somerhanna/Automatic-Chicken-Door/door_display.png

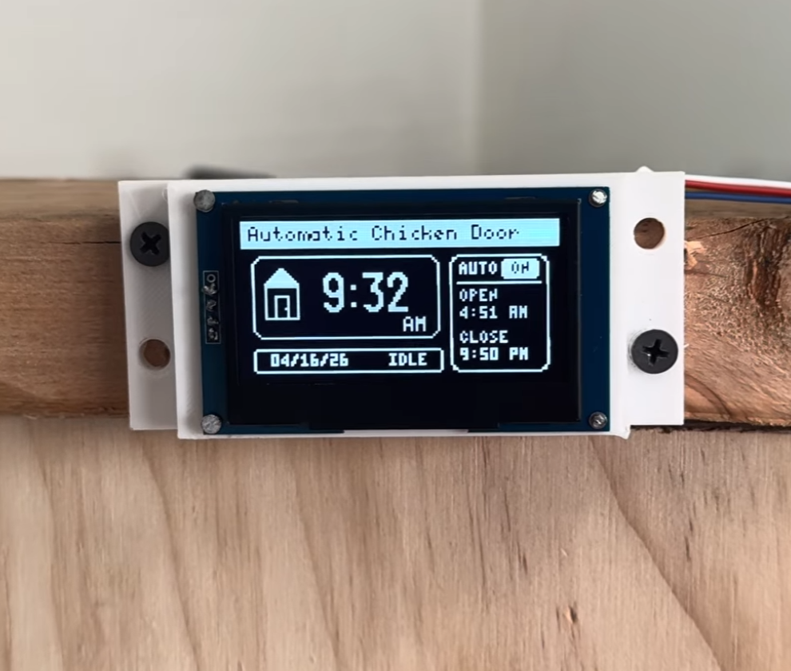
door_display.png
