somerhanna/Automatic-Chicken-Door/door_box.png

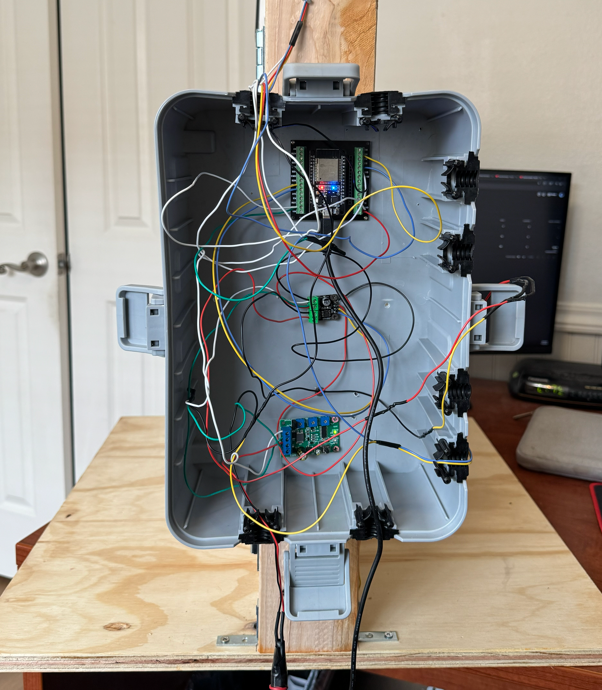
door_box.png
