somerhanna/Automatic-Chicken-Door/3D_utils/readme

The 3D models I made to house the limit switches and the 12V worm gear motor.

The 12V worm gear motor I used is commonly avaliable on various websites (Amazon, Temu, etc.) - BRINGSMART.

I added a picture of it so if you have the same one you can 3D print your own housing for it (it holds it very firmly).

Print the 2 halves and place them together, held with 2 screws. I also uploaded the full version.
