somerhanna/Automatic-Chicken-Door/3D_utils/wormgearmotor12.jpg

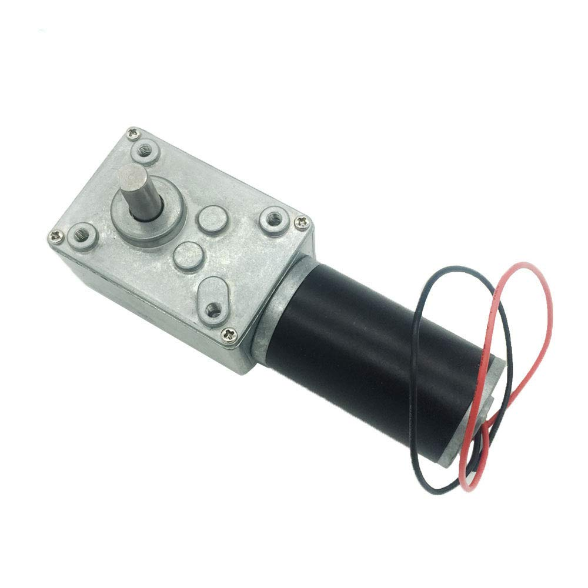
3D_utils/wormgearmotor12.jpg
