somerhanna/Automatic-Chicken-Door/chicken_door_app.png

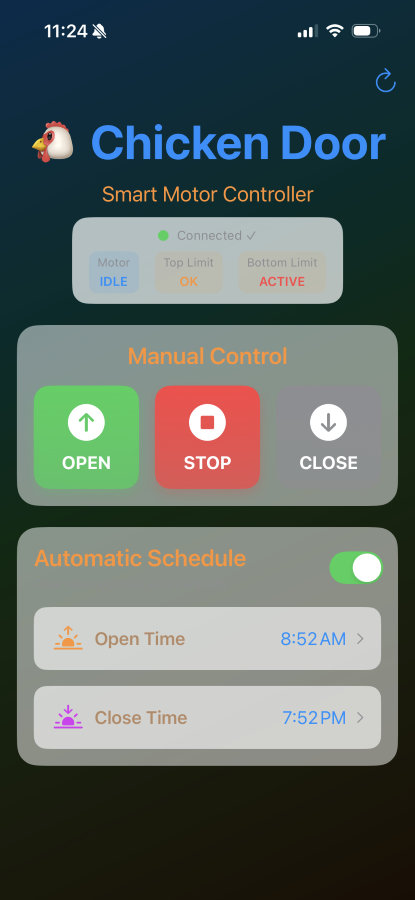
chicken_door_app.png
