somerhanna/Automatic-Chicken-Door/door_back.png

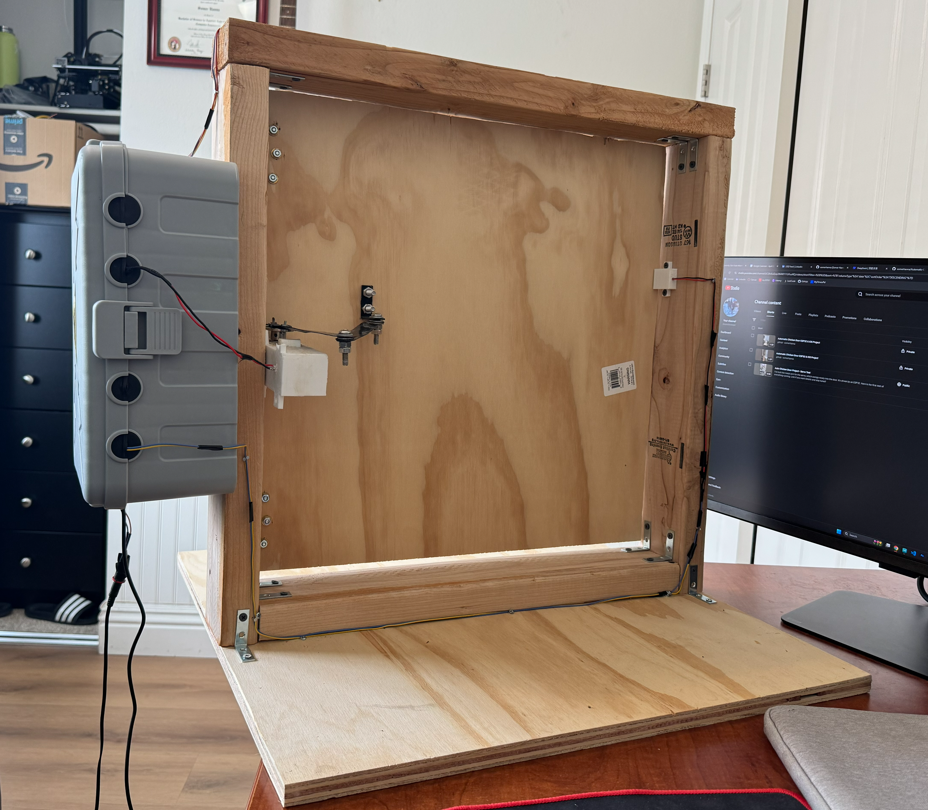
door_back.png
