somerhanna/Automatic-Chicken-Door/door_front.png

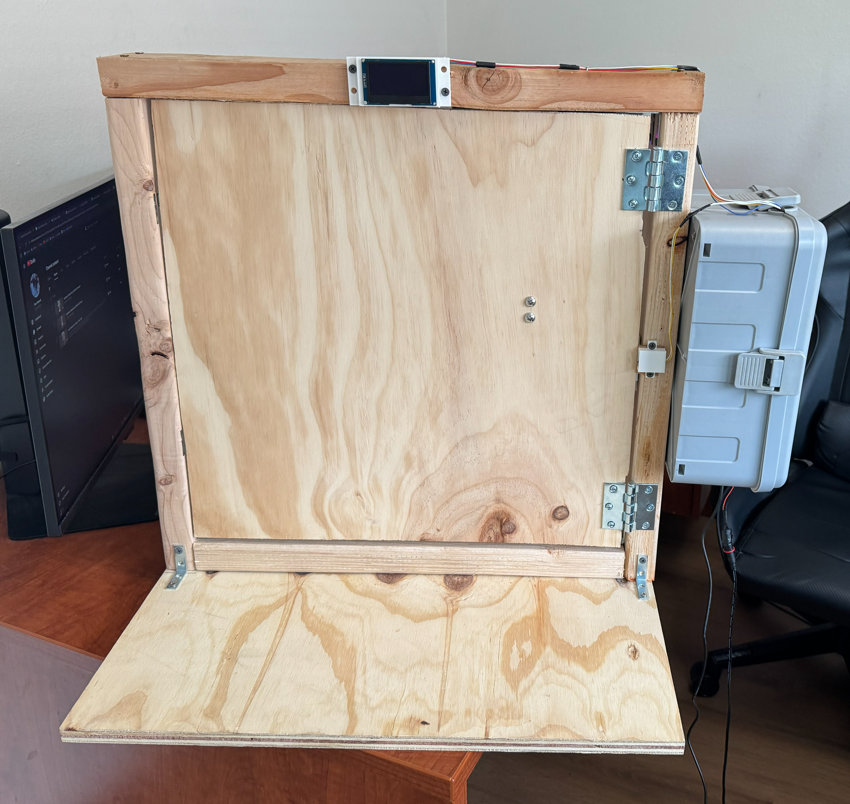
door_front.png
