somerhanna/Automatic-Chicken-Door/pin_config.png

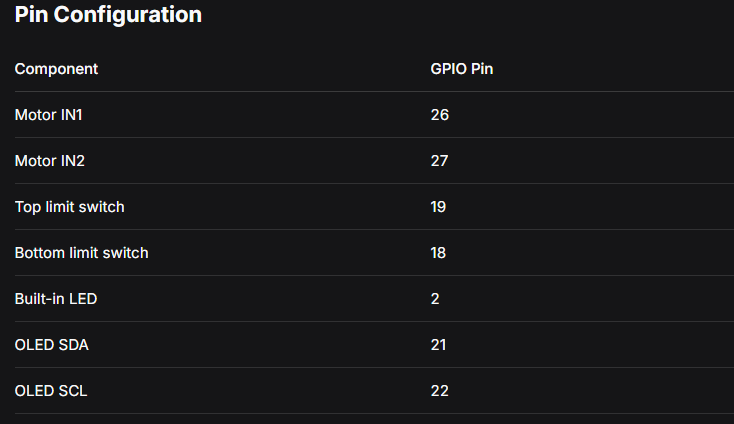
pin_config.png
