somerhanna/Automatic-Chicken-Door/3D_utils/V2 12V Chicken Motor Mount half1.stl

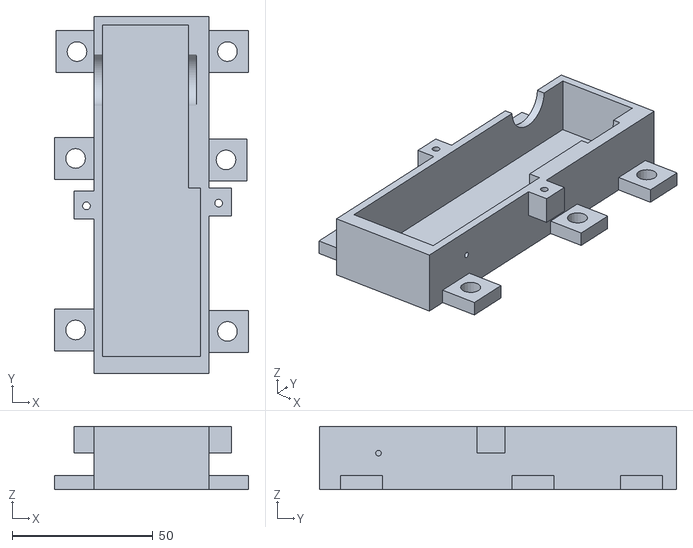
[picture p8: CAD file, 2026-08-10]
3D_utils/V2 12V Chicken Motor Mount half1.stl
69.0 x 127.0 x 22.5
