somerhanna/Automatic-Chicken-Door/3D_utils/V2 12V Chicken Motor Mount half2.stl

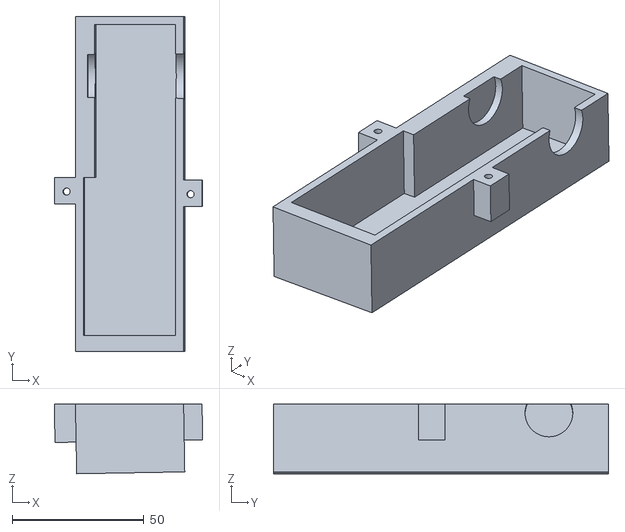
[picture p9: CAD file, 2026-08-10]
3D_utils/V2 12V Chicken Motor Mount half2.stl
56.2 x 127.0 x 26.4
