somerhanna/Automatic-Chicken-Door/3D_utils/OLEDHouse.stl

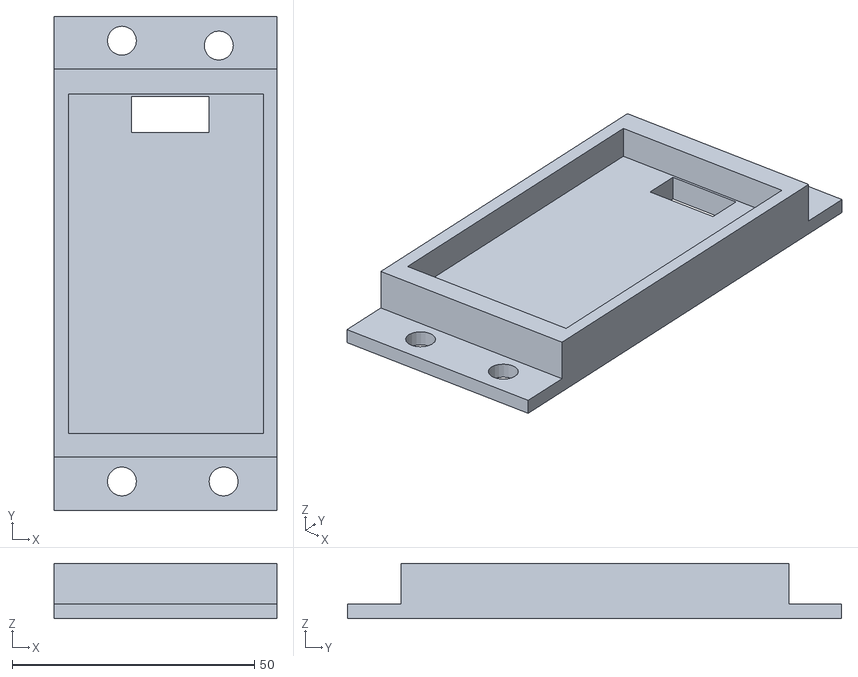
[picture p10: CAD file, 2026-08-10]
3D_utils/OLEDHouse.stl
46.0 x 102.0 x 11.4
