somerhanna/Automatic-Chicken-Door/3D_utils/Limit Switch House.stl

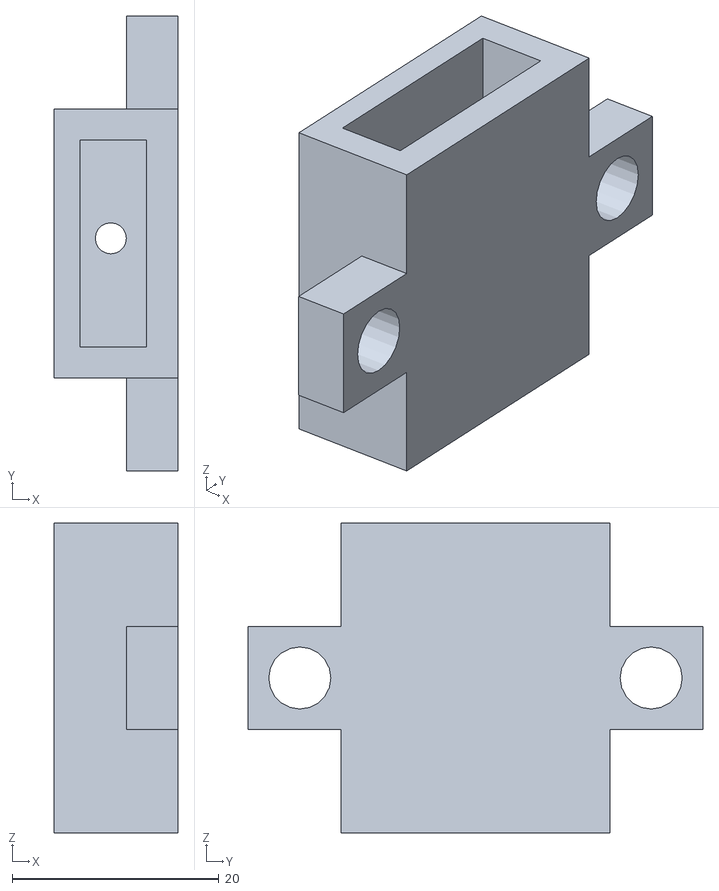
[picture p11: CAD file, 2026-08-10]
3D_utils/Limit Switch House.stl
12.0 x 44.0 x 30.0
