somerhanna/Automatic-Chicken-Door/3D_utils/D shaft mount.stl

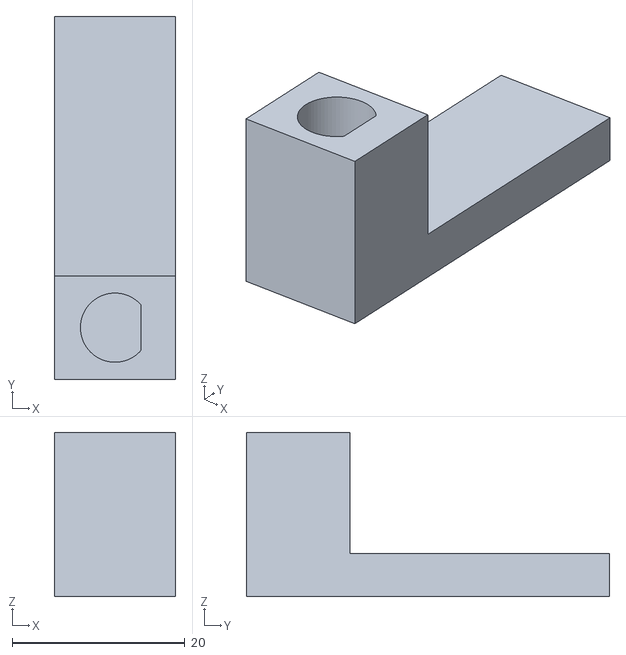
[picture p12: CAD file, 2026-08-10]
3D_utils/D shaft mount.stl
14.0 x 42.0 x 19.0
