somerhanna/Automatic-Chicken-Door/3D_utils/V2 12V Chicken Motor Mount.stl

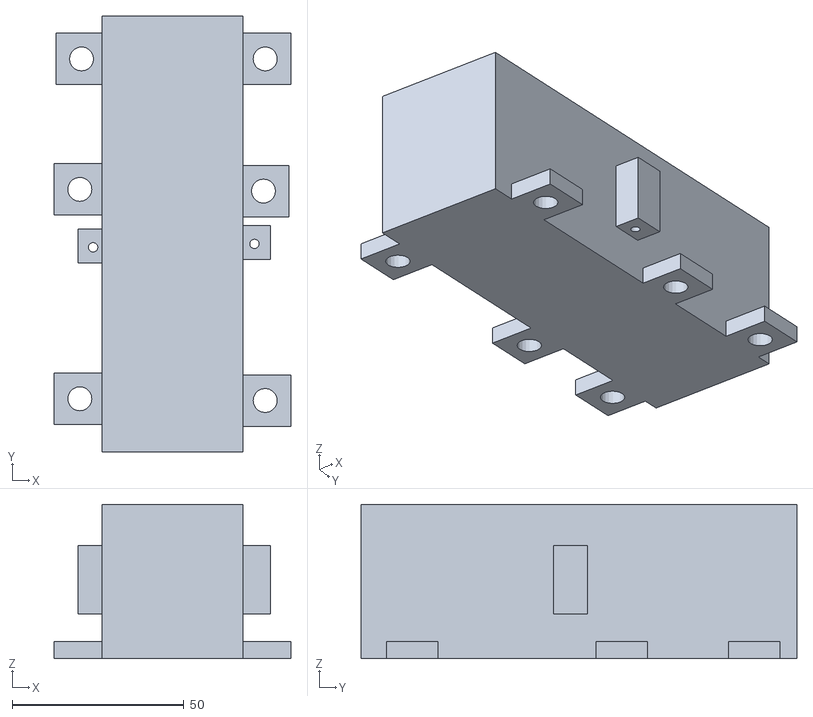
[picture p13: CAD file, 2026-08-10]
3D_utils/V2 12V Chicken Motor Mount.stl
69.0 x 127.0 x 45.0
