somerhanna/Automatic-Chicken-Door/ChickenDoor/src/time_sync.h

#ifndef TIME_SYNC_H
#define TIME_SYNC_H

#include <Arduino.h>

// Time sync
extern bool timeInitialized;
extern int currentDay;
extern bool timeSyncInProgress;

bool performSafeTimeSync();
bool syncTimeWithNTP();
void disconnectWiFi();
void printTime();

#endif // TIME_SYNC_H
