somerhanna/Automatic-Chicken-Door/(commit log)

2026-03-18 connect to esp32
2026-03-19 set onboard LED via BLE thru iOS app
2026-03-24 DRV8871 sketch
    Simple start & stop with serial monitor, connecting IN1 & IN2 from driver to GPIO26 & 27
2026-03-26 Create motormoveapp
2026-06-10 Rename main to automatic_chicken_door
    Automatic chicken door controller for ESP32
    WiFi time sync + BLE control + motor with limit switches + OLED display
2026-08-10 Add files via upload
    the two halves (to print)
    [V2 12V Chicken Motor Mount half1.stl, V2 12V Chicken Motor Mount half2.stl]
2026-08-19 Update i2C Speed
2026-08-20 remove I2C speed
2026-08-20 Reducing WiFI power consumption to try to debug brownout
    [time_sync.cpp]
2026-08-20 adding delays between BLE / WiFI to prevent brownouts
    [main.cpp, time_sync.cpp]
2026-08-20 changed the motor run timeout from 6 seconds to 4 seconds (it takes about ~3 seconds to hit the limit switch... this will prevent it from overdriving if the limit switch misses
    [config.cpp]
2026-08-22 added a mutex to prevent a potential race condition between schedule onWrite interrupt firing and core 1 reading from the old value
    [ble_comm.cpp, ble_comm.h, schedule.cpp, schedule.h]
2026-08-22 add motorMux extern declaration
2026-08-22 add mutexes for motor state variables
2026-08-22 read motor state atomically in sendStatus()
2026-08-22 added mutex for motor state variables
2026-08-22 read motor state automatically in sendStatus()
2026-08-22 fix schedule: use local copies from mutex in checkSchedule()
    [schedule.cpp]
2026-08-22 declare initBLE() prototype in ble_comm.h
2026-08-22 fixing a bug where BLE & WiFi work at the same time during nightly reset
    [ble_comm.cpp, ble_comm.h, display.cpp, display.h, schedule.cpp, time_sync.cpp, time_sync.h]
2026-08-23 add mutex to the critical section of reading limit switch
2026-09-14 Fix comment formatting in ble_comm.cpp
    Updated comment formatting in ble_comm.cpp.
    [ble_comm.cpp]
2026-09-17 Fix comment formatting in config.h
    [config.h]
